kolmeto1sta3-akk/amplifier-pcb/docs/amplifier_schematic.pdf

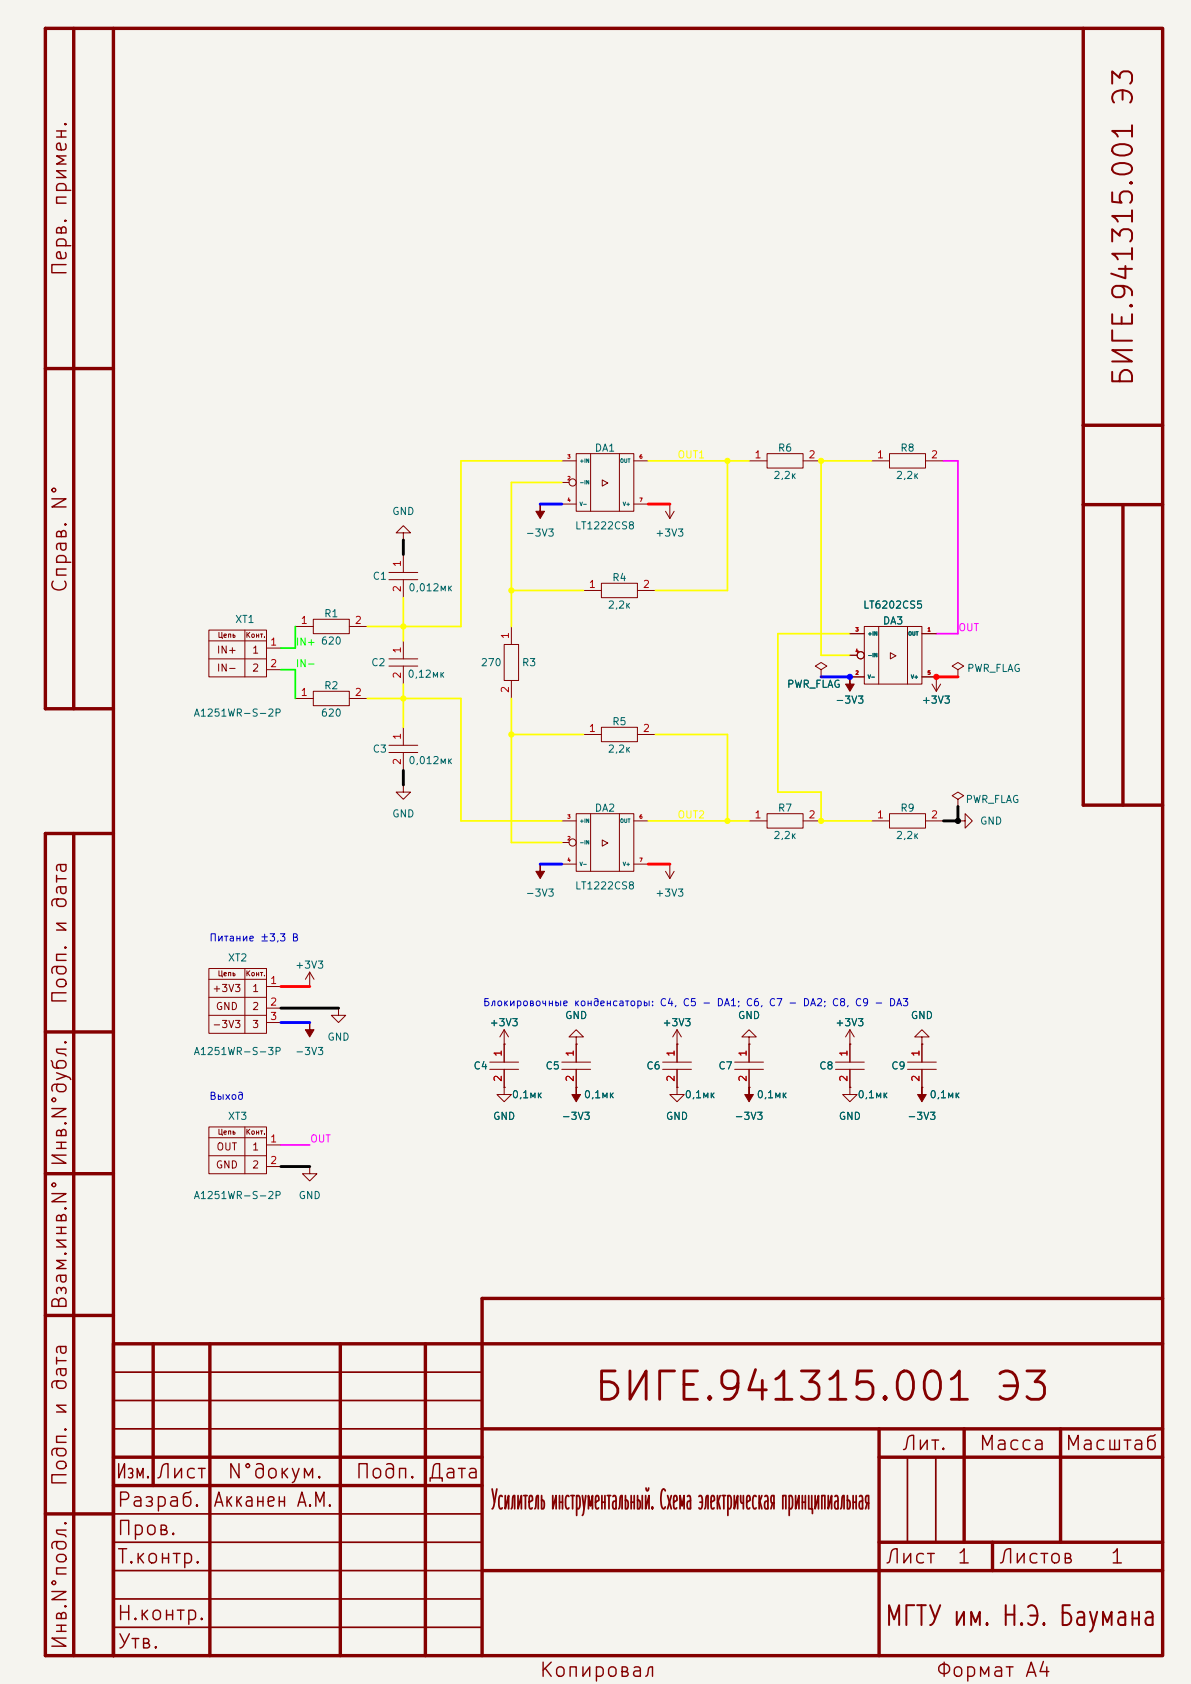
[picture p7: page 1]

Н.контр. Перв. примен. Подп. и дата Подп. и дата

V+ OUT | 7 DA1

IN+
IN- | 2

Цепь +3V3 GND -3V3

Конт. 1

Цепь OUT GND

Лист | | Подп.

Акканен А.М.

Усилитель инструментальный. Схема электрическая принципиальная

Пров.
Т.контр.
