kolmeto1sta3-akk/amplifier-pcb/amplifier.kicad_pcb

## KiCad design amplifier.kicad_pcb (2026-10-29)

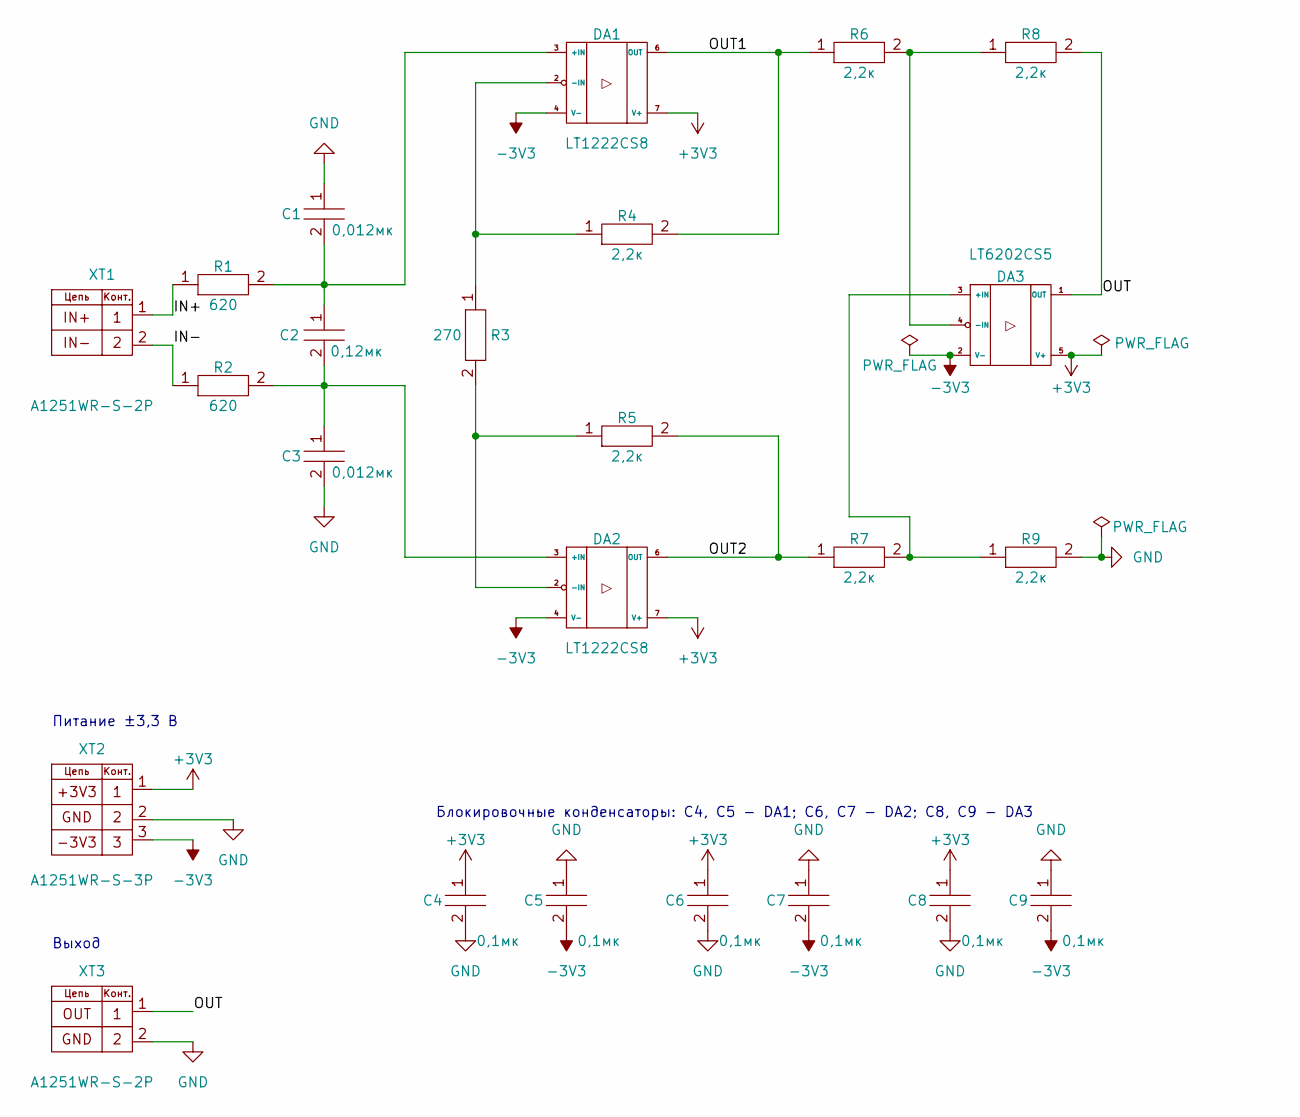
[picture p8: schematic amplifier.kicad_sch, Усилитель инструментальный. Схема электрическая принципиаль…]

Parts:
C1, C3: 0,012мк; C_0805_2012Metric; Manufacturer_Part_Number CL21B123KBANNNC
C2: 0,12мк; C_0805_2012Metric; Manufacturer_Part_Number C0805C124K1RACTU
C4, C5, C6, C7, C8, C9: 0,1мк; C_0805_2012Metric; Manufacturer_Part_Number CL21B104KBFNNNE
DA1, DA2: LT1222CS8; SOIC-8_3.9x4.9mm_P1.27mm; Manufacturer_Part_Number LT1222CS8#PBF
DA3: LT6202CS5; SOT-23-5; Manufacturer_Part_Number LT6202CS5#TRMPBF
R1, R2: 620; R_0805_2012Metric; Manufacturer_Part_Number RC0805FR-07620RL
R3: 270; R_0805_2012Metric; Manufacturer_Part_Number RC0805FR-07270RL
R4, R5, R6, R7, R8, R9: 2,2к; R_0805_2012Metric; Manufacturer_Part_Number RC0805FR-072K2L
XT1, XT3: A1251WR-S-2P; Molex_PicoBlade_53048-0210_1x02_P1.25mm_Horizontal; Manufacturer_Part_Number A1251WR-S-2P
XT2: A1251WR-S-3P; Molex_PicoBlade_53048-0310_1x03_P1.25mm_Horizontal; Manufacturer_Part_Number A1251WR-S-3P

Connections:
+3V3: C4.1, C6.1, C8.1, DA1.7 (V+), DA2.7 (V+), DA3.5 (V+), XT2.1
-3V3: C5.2, C7.2, C9.2, DA1.4 (V-), DA2.4 (V-), DA3.2 (V-), XT2.3
/IN+: R1.1, XT1.1
/IN-: R2.1, XT1.2
/OUT: DA3.1 (OUT), R8.2, XT3.1
/OUT1: DA1.6 (OUT), R4.2, R6.1
/OUT2: DA2.6 (OUT), R5.2, R7.1
GND: C1.1, C3.2, C4.2, C5.1, C6.2, C7.1, C8.2, C9.1, R9.2, XT2.2, XT3.2
unnamed: C1.2, C2.1, DA1.3 (+IN), R1.2
unnamed: DA1.2 (-IN), R3.1, R4.1
unnamed: C2.2, C3.1, DA2.3 (+IN), R2.2
unnamed: DA2.2 (-IN), R3.2, R5.1
unnamed: DA3.3 (+IN), R7.2, R9.1
unnamed: DA3.4 (-IN), R6.2, R8.1

Notes on the sheet:
Питание ±3,3 В
Выход
Блокировочные конденсаторы: C4, C5 - DA1; C6, C7 - DA2; C8, C9 - DA3

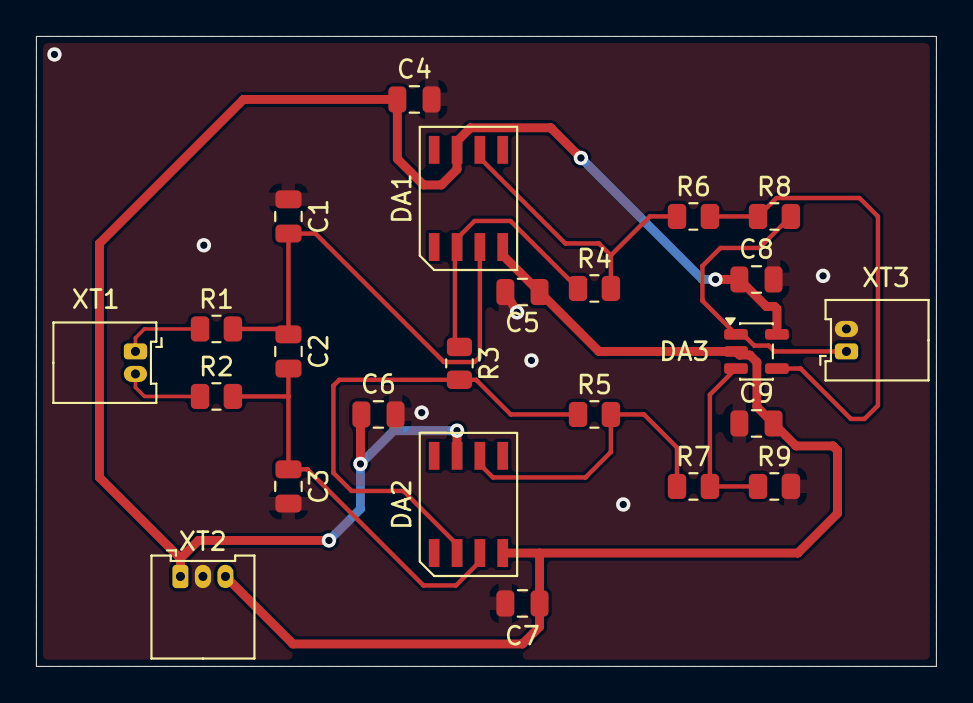
[picture p9: board amplifier.kicad_pcb from above]

Board: 2 copper layers, 50.0 x 35.0 mm, 24 parts (0 on the bottom side), 14 nets.
