kolmeto1sta3-akk/amplifier-pcb/(commit log)

2026-10-23 Проект платы: схема по ГОСТ, классы цепей, сабмодуль библиотеки, расстановка, скрипт
    [amplifier.kicad_pcb, amplifier.kicad_sch]
2026-10-25 Ручная разводка платы, DRC 0, партномера C1-C3, README и отчёт PDF
    [amplifier.kicad_pcb, amplifier.kicad_sch]
2026-10-25 Основная надпись: БИГЕ.941315.001 Э3, обновлены PDF схемы и отчёт
    [amplifier.kicad_pcb, amplifier.kicad_sch]
2026-10-27 Правки README, пересобран отчёт README.pdf
2026-10-29 УГО ОУ по ГОСТ 2.759, трассировка без острых и прямых углов
    - library: ОУ с разделительными линиями доп. полей
    - плата: изломы только 45°, новый переход у DA2.7, DRC 0/0/0
    - обновлены docs, README, README.pdf
    Claude-Session: https://claude.ai/code/session_01Q3XDjd6y7RpdZFKAKCxfku
    [amplifier.kicad_pcb, amplifier.kicad_sch]
